thatdecade/Smart-Thermostat-IR-Blaster/hardware/smart_blaster_schematic.png

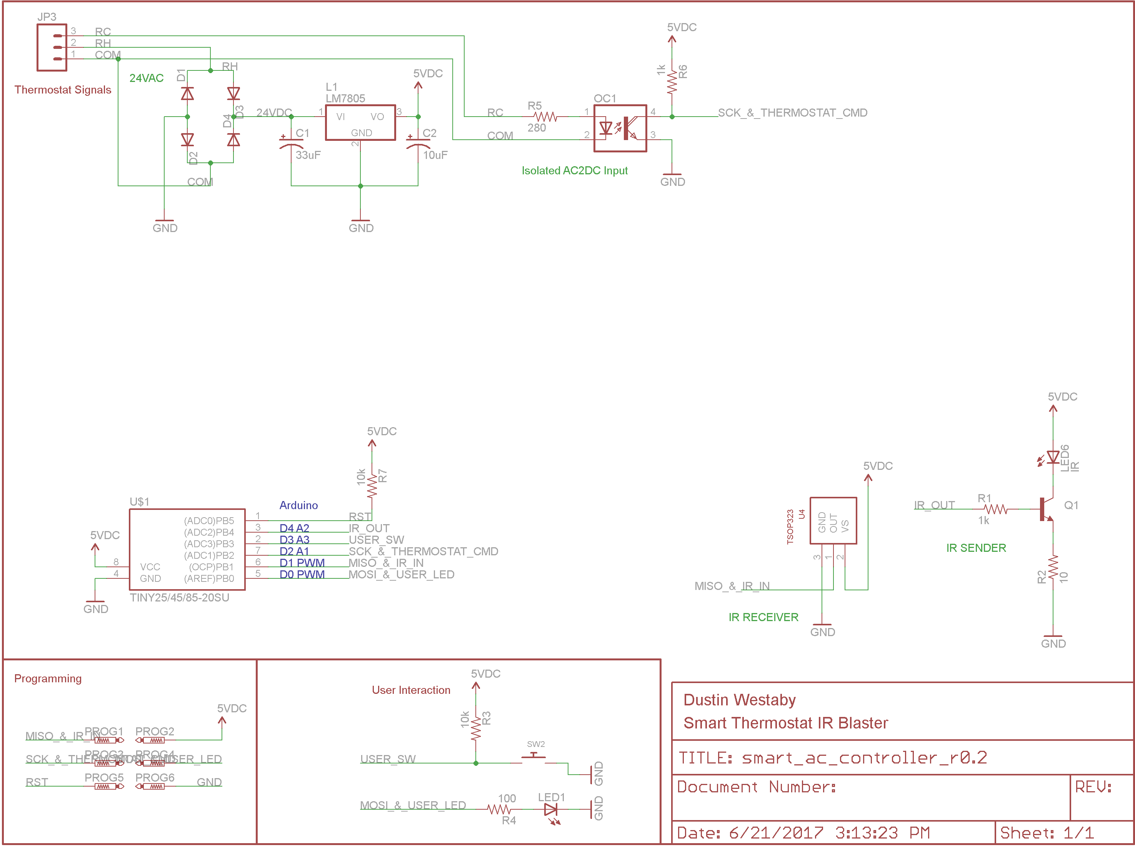
hardware/smart_blaster_schematic.png
