thatdecade/Smart-Thermostat-IR-Blaster/(threads)

Thread 1 (2019-12-27):

Schematic connection issue?

hastypete, 2019-12-27:
The schematic shows connections to the nest with C, RH, and RC.
C is common
RH is power for the heating relay
RC is power for the cooling relay

The RH goes to the 5V regulator for the rest of the circuit.

The RC goes to a 280 ohm resistor and to a optoisolator.
The way it's drawn it seems that the optoisolator will always have 24AC on it which doesn't indicate that the AC is on.  Shouldn't that be connected to the Y signal?

2nd issue, isn't 24AC going to provide way too much current for the optoisolator?  Also AC will cause a pulsing signal at 60 hz on the optoisolator.

- Peter Holley

thatdecade, 2019-12-27:
Hi Peter,

You are correct. RC is the 24VAC for cooling and the Y is the cooling
signal wire. the schematic has mistakes, follow the readme and .ino wiring
notes.

Do you have a multimeter handy? Can measure the active signals to see what
they look like. They are pretty simple.
https://youtu.be/ZZC0SP02PqY

Let’s see, 24VAC / 280 ohm is 85mA.  The optoisolator has a max input of
150mA and a nominal of 100mA.  We just have to reach 2.2V on the output to
be seen as a logic 1 by the avr chip. So should be fine :)

For filtering the AC pulse signals, take a look at the debounce_ac_input()
function in the .ino file.  That should explain everything how the AC is
filtered.

Thanks,
Dustin

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

rsemedo2002, 2019-12-27:
Hey guys,
Apologies to get in the middle of this conversation, but I was keen on trying this on my Nest with my Fujitsu mini split...I've basic electric skills, not capable of pulling this circuit together on my own, would any of you be willing to build one for me...? Happy to pay for labor+parts... :-) any help would be much appreciated. Cheers.

thatdecade, 2019-12-27:
Send me an email, I’ll hook you up. thatdecade@gmail.com

rsemedo2002, 2019-12-27:
Done.

hastypete, 2019-12-27:
280 ohms at 24V is 2 Watts.  The current is good, but the wattage is high for a typical 1/2W resistor.
Has that been a problem?
I'm looking at using a 24AC relay instead of optoisolator anyway.

My idea is to 3D print a small base that sits underneath the nest to hold the electronics and the emitter.  It would be the same color and size as the nest.

- Peter

thatdecade, 2019-12-27:
I like your idea for the enclosure.  Mine was to mount it under the nest's wall mount. However, I realize that not everyone used that piece and a proper 3D printed enclosure would be a nice addition.

You are correct about the wattage, my quick math also says ~2 watts.  A 24VAC relay would be a better and more standard solution for HVAC, just a bit bigger.

---------
In defense of the optoisolator:

If you google up on the optoisolator I used, LTV-814.  You will find that it has an internal diode making it safe to connect the input directly to AC without rectification.  In addition, the resistor dissipates much less power than the math says it should.
https://electronics.stackexchange.com/questions/461445/resistor-power-dissipation-when-driving-optocoupler-from-ac-mains

Here is from the LTV-814 datasheet:

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

Collector current is 5mA, so to see >2.2V output we need a current of >10mA to the input.  You can swap the 280 ohm resistor for a 1000 ohm and the circuit will still work and only need a 1/4W resistor.

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

If you reduce the collector current to 1mA by using a 5k resistor on the output side, then you can get away with ~5mA to the input and still have >2.2V seen at the output to activate the avr's high logic.  That gives us an input resistor of 4700 ohm and a dissipation power of ~1/10W.
